luuquocminh0605/Developing-an-environmental-monitoring-IoT-system-based-on-a-low-power-wide-area-network/Mô hình hệ thống mạng diện rộng công suất thấp LoRa/PCB/node/node.pdf

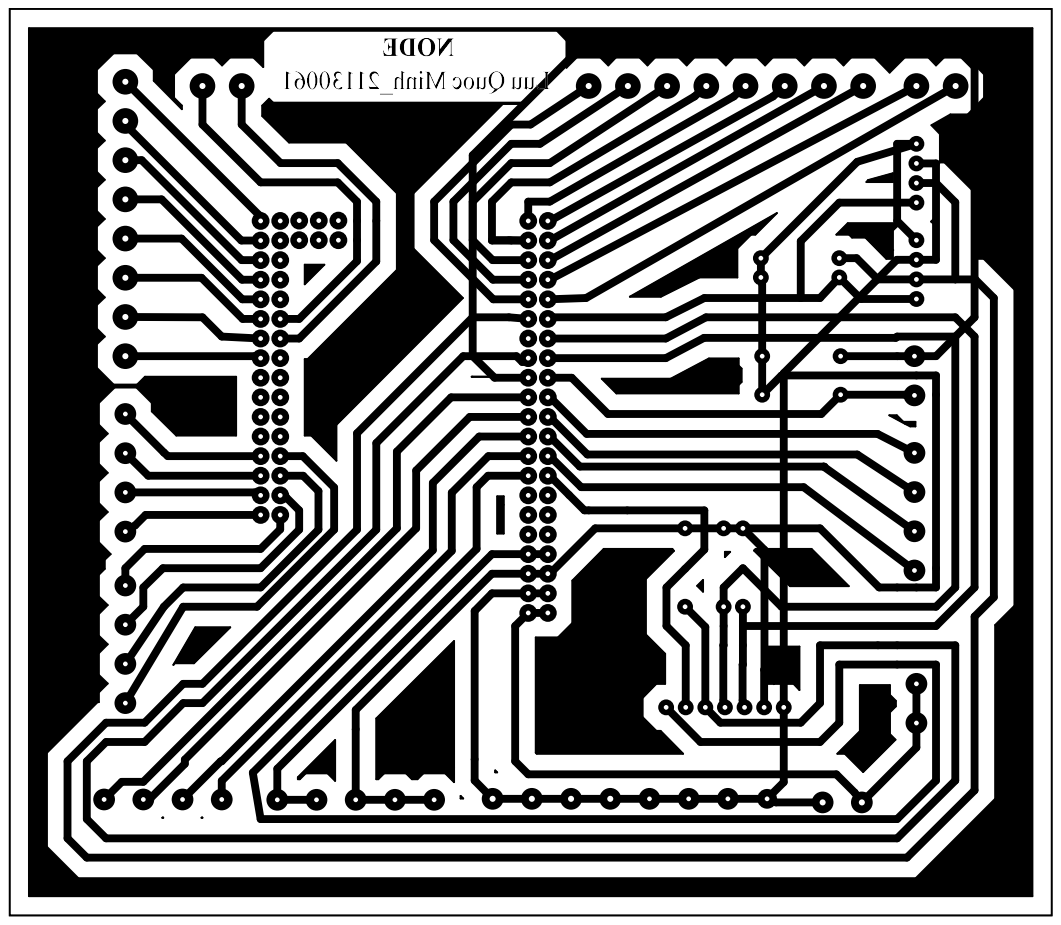
[picture p31: page 1]
