luuquocminh0605/Developing-an-environmental-monitoring-IoT-system-based-on-a-low-power-wide-area-network/(list of files, drawings)

Other design files:
Mô hình hệ thống mạng diện rộng công suất thấp LoRa/PCB/gateway/lora.pdsprj
Mô hình hệ thống mạng diện rộng công suất thấp LoRa/PCB/gateway/Project Backups/lora [20250414, 19-01-24].pdsprj
Mô hình hệ thống mạng diện rộng công suất thấp LoRa/PCB/gateway/Project Backups/lora [20250416, 12-05-09].pdsprj
Mô hình hệ thống mạng diện rộng công suất thấp LoRa/PCB/gateway/Project Backups/lora [20250416, 12-06-52].pdsprj
Mô hình hệ thống mạng diện rộng công suất thấp LoRa/PCB/gateway/Project Backups/lora [20250416, 12-07-55].pdsprj
Mô hình hệ thống mạng diện rộng công suất thấp LoRa/PCB/gateway/Project Backups/lora [20250416, 22-13-31].pdsprj
Mô hình hệ thống mạng diện rộng công suất thấp LoRa/PCB/gateway/Project Backups/lora [20250421, 17-38-08].pdsprj
Mô hình hệ thống mạng diện rộng công suất thấp LoRa/PCB/gateway/Project Backups/lora [20250421, 17-38-55].pdsprj
Mô hình hệ thống mạng diện rộng công suất thấp LoRa/PCB/gateway/Project Backups/lora [20250421, 17-54-41].pdsprj
Mô hình hệ thống mạng diện rộng công suất thấp LoRa/PCB/gateway/Project Backups/lora [20250422, 21-44-43].pdsprj
Mô hình hệ thống mạng diện rộng công suất thấp LoRa/PCB/gateway/Project Backups/lora [20250422, 22-39-22].pdsprj
Mô hình hệ thống mạng diện rộng công suất thấp LoRa/PCB/node/node.pdsprj
Mô hình hệ thống mạng diện rộng công suất thấp LoRa/PCB/node/Project Backups/node [20250422, 18-33-01].pdsprj
Mô hình hệ thống mạng diện rộng công suất thấp LoRa/PCB/node/Project Backups/node [20250422, 18-35-32].pdsprj
Mô hình hệ thống mạng diện rộng công suất thấp LoRa/PCB/node/Project Backups/node [20250422, 19-31-27].pdsprj
Mô hình hệ thống mạng diện rộng công suất thấp LoRa/PCB/node/Project Backups/node [20250422, 20-51-23].pdsprj
Mô hình hệ thống mạng diện rộng công suất thấp LoRa/PCB/node/Project Backups/node [20250422, 20-59-49].pdsprj
Mô hình hệ thống mạng diện rộng công suất thấp LoRa/PCB/node/Project Backups/node [20250422, 21-32-50].pdsprj
Mô hình hệ thống mạng diện rộng công suất thấp LoRa/PCB/node/Project Backups/node [20250422, 21-33-13].pdsprj
Mô hình hệ thống mạng diện rộng công suất thấp LoRa/PCB/node/Project Backups/node [20250424, 17-35-28].pdsprj
Mô hình hệ thống mạng diện rộng công suất thấp LoRa/PCB/node/Project Backups/node [20250424, 18-18-45].pdsprj
Mô hình hệ thống mạng diện rộng công suất thấp LoRa/PCB/node/Project Backups/node [20250629, 10-45-07].pdsprj
